fablabbcn/smartcitizen-kit-pm-board/hardware/README.md

Smart Citizen Kit 2.0 PM Board Hardware
=======================================

This folder contains the Eagle design files for the Smart Citizen Kit 2.0 PM Board

## License

All the software is released under [GNU GPL v3.0](https://github.com/fablabbcn/smartcitizen-kit-20/blob/master/LICENSE) and the hardware design files under [CERN OHL v1.2](https://github.com/fablabbcn/smartcitizen-kit-20/blob/master/hardware/LICENSE)
