fablabbcn/smartcitizen-kit-pm-board/hardware/SCK_2.0_PM_BOARD_1.1_rev_1/SCK_2.0_PM_BOARD_1.1_rev_1_BOM.ods

Part | Value | Device | Description | Provider | MPN |  | # | Val | Cas | ManRef | ProRef | Pro | Cost | Man 1 | ProRef 1 | Pro 1 | Cost 1
C1 | 22pf | CERAMIC-22PF-50V-5%-NPO(0402) | 302010018 | Seeed | CC0402JRNPO9BN220 |  | C1 | 22pF | 0402 | CC0402JRNPO9BN220 | 302010018 | SeeedStudio | 0.01 €
C10 | 100nf | CERAMIC-100NF-50V-10%-X7R(0603) | 302010138 | Seeed | CC0603KRX7R9BB104 |  | C10 | 100nF | 0603 | CC0603KRX7R9BB104 | 302010138 | SeeedStudio | 0.01 €
C11 | 100nf | CERAMIC-100NF-50V-10%-X7R(0603) | 302010138 | Seeed | CC0603KRX7R9BB104 |  | C11 | 100nF | 0603 | CC0603KRX7R9BB104 | 302010138 | SeeedStudio | 0.01 €
C12 | 100nf | CERAMIC-100NF-50V-10%-X7R(0603) | 302010138 | Seeed | CC0603KRX7R9BB104 |  | C12 | 100nF | 0603 | CC0603KRX7R9BB104 | 302010138 | SeeedStudio | 0.01 €
C13 | 100nf | CERAMIC-100NF-50V-10%-X7R(0603) | 302010138 | Seeed | CC0603KRX7R9BB104 |  | C13 | 100nF | 0603 | CC0603KRX7R9BB104 | 302010138 | SeeedStudio | 0.01 €
C14 | 100nf | CERAMIC-100NF-50V-10%-X7R(0603) | 302010138 | Seeed | CC0603KRX7R9BB104 |  | C14 | 100nF | 0603 | CC0603KRX7R9BB104 | 302010138 | SeeedStudio | 0.01 €
C15 | 2.2nf | CERAMIC-2.2NF-50V-10%-X7R(0402) | 302010022 | Seeed | CC0402KRX7R9BB222 |  | C15 | 2,2nF | 0402 | CC0402KRX7R9BB222 | 302010022 | SeeedStudio | 0.01 €
C16 | 22uF | CERAMIC-22UF-16V-10%-X7R(1206) | 302010182 | Seeed |  |  | C16 | 22uF | 1206 |  | 302010182 | SeeedStudio | 0.02 € | EMK316BB7226ML-T | 963-EMK316BB7226ML-T | Mouser | 0.87
C17 | 10uf | CERAMIC-10UF-25V-10%-X5R(1206) | 302010181 | Seeed | CC1206KKX5R8BB106 | change to 10uf OK | C17 | 22uF | 1206 |  | 302010182 | SeeedStudio | 0.02 € | EMK316BB7226ML-T | 963-EMK316BB7226ML-T | Mouser | 0.87
C18 | 100pf | CERAMIC-100PF-50V-5%-NPO(0603) | 302010076 | Seeed | CC0603JRNPO9BN101 |  | C18 | 100pF | 0603 | CC0603JRNPO98N101 | 302010076 | SeeedStudio | 0.01 €
C19 | 100nf | CERAMIC-100NF-50V-10%-X7R(0603) | 302010138 | Seeed | CC0603KRX7R9BB104 |  | C19 | 100nF | 0603 | CC0603KRX7R9BB104 | 302010138 | SeeedStudio | 0.01 €
C2 | 22pf | CERAMIC-22PF-50V-5%-NPO(0402) | 302010018 | Seeed | CC0402JRNPO9BN220 |  | C2 | 22pF | 0402 | CC0402JRNPO9BN220 | 302010018 | SeeedStudio | 0.01 €
C20 | 100nf | CERAMIC-100NF-50V-10%-X7R(0603) | 302010138 | Seeed | CC0603KRX7R9BB104 |  | C20 | 100nF | 0603 | CC0603KRX7R9BB104 | 302010138 | SeeedStudio | 0.01 €
C21 | 100nf | CERAMIC-100NF-50V-10%-X7R(0603) | 302010138 | Seeed | CC0603KRX7R9BB104 |  | C21 | 100nF | 0603 | CC0603KRX7R9BB104 | 302010138 | SeeedStudio | 0.01 €
C22 | 4.7nf | CERAMIC-4.7NF-50V-10%-X7R(0603) | 302010144 | Seeed | CC0603KRX7R9BB472 |  | C22 | 4,7nF | 0603 | CC0603KRX7R9BB472 | 302010144 | SeeedStudio | 0.01 €
C23 | 100nf | CERAMIC-100NF-50V-10%-X7R(0603) | 302010138 | Seeed | CC0603KRX7R9BB104 | add OK
C24 | 1uf | CERAMIC-1UF-25V-10%-X7R(0805) | 302010179 | Seeed | CC0805KKX7R8BB105 | add OK
C25 | 4.7uf | CERAMIC-4.7UF-25V-10%-X5R(0805) | 302010146 | Seeed | CC0805KKX5R8BB475 | add OK
C26 | 100nf | CERAMIC-100NF-50V-10%-X7R(0805) | 302010165 | Seeed | CC0805KRX7R9BB104 | add OK
C27 | 100nf | CERAMIC-100NF-50V-10%-X7R(0805) | 302010165 | Seeed | CC0805KRX7R9BB104 | add OK
C3 | 10uf | CERAMIC-10UF-25V-10%-X5R(1206) | 302010181 | Seeed | CC1206KKX5R8BB106 | change to ceramic OK | C3 | 10uF | AVX-A | TAJA106K016RNJ | 302020002 | SeeedStudio | 0.05 €
C4 | 22uF | CERAMIC-22UF-16V-10%-X7R(1206) | 302010182 | Seeed |  | change to ceramic OK | C4 | 22uF | AVX-A | TAJA226K010RNJ | 302020008 | SeeedStudio | 0.05 €
C5 | 4.7uf | CERAMIC-4.7UF-25V-10%-X5R(0805) | 302010146 | Seeed | CC0805KKX5R8BB475 |  | C5 | 4,7uF | 0805 | CC0805KKX5R8BB475 | 302010146 | SeeedStudio | 0.01 €
C6 | 100nf | CERAMIC-100NF-50V-10%-X7R(0603) | 302010138 | Seeed | CC0603KRX7R9BB104 |  | C6 | 100nF | 0603 | CC0603KRX7R9BB104 | 302010138 | SeeedStudio | 0.01 €
C7 | 1uf | CERAMIC-1UF-25V-10%-X7R(0603) | 302010139 | Seeed | CC0603KRX7R8BB105 |  | C7 | 1uF | 0603 | CC0603KRX7R8BB105 | 302010139 | SeeedStudio | 0.01 €
C8 | 100nf | CERAMIC-100NF-50V-10%-X7R(0603) | 302010138 | Seeed | CC0603KRX7R9BB104 |  | C8 | 100nF | 0603 | CC0603KRX7R9BB104 | 302010138 | SeeedStudio | 0.01 €
C9 | 100nf | CERAMIC-100NF-50V-10%-X7R(0603) | 302010138 | Seeed | CC0603KRX7R9BB104 |  | C9 | 100nF | 0603 | CC0603KRX7R9BB104 | 302010138 | SeeedStudio | 0.01 €
D1 | 20V-1A | SMD-DIODE-SCHOTTKY-20V-1A(SOD-123) | 304020034 | Seeed | B5819W |  | D1 | 20V/1A | SOD-123 | B5819W | 304020034 | SeeedStudio | 0.02 €
D2 | 20V-1A | SMD-DIODE-SCHOTTKY-20V-1A(SOD-123) | 304020034 | Seeed | B5819W |  | D2 | 20V/1A | SOD-123 | B5819W | 304020034 | SeeedStudio | 0.02 €
D3 | 20V-500MA | SMD-DIODE-SCHOTTKY-20V-500MA(SOD-123)P | 304020028 | Seeed | MBR0520LT1G |  | D3 | 20V/500mA | SOD-123 | MBR0520LT1G | 304020028 | SeeedStudio | 0.03 €
D4 | 20V-500MA | SMD-DIODE-SCHOTTKY-20V-500MA(SOD-123)P | 304020028 | Seeed | MBR0520LT1G |  | D4 | 20V/500mA | SOD-123 | MBR0520LT1G | 304020028 | SeeedStudio | 0.03 €
D5 | 20V-500MA | SMD-DIODE-SCHOTTKY-20V-500MA(SOD-123)P | 304020028 | Seeed | MBR0520LT1G |  | D5 | 20V/500mA | SOD-123 | MBR0520LT1G | 304020028 | SeeedStudio | 0.03 €
D6 | 20V-500MA | SMD-DIODE-SCHOTTKY-20V-500MA(SOD-123)P | 304020028 | Seeed | MBR0520LT1G |  | D6 | 20V/500mA | SOD-123 | MBR0520LT1G | 304020028 | SeeedStudio | 0.03 €
D7 | 20V-500MA | SMD-DIODE-SCHOTTKY-20V-500MA(SOD-123)P | 304020028 | Seeed | MBR0520LT1G |  | D7 | 20V/500mA | SOD-123 | MBR0520LT1G | 304020028 | SeeedStudio | 0.03 €
IC1 | SAMD21G18A-MUT | Atmel D21 32bit ARM Cortex-M0 microcontroller - 48 PIN TQFP | 310010095 | Seeed | SAMD21G18A-MUT |  | IC1 | SAM | VFQFN-48 | ATSAMD21G18A-MU | 310010095 | SeeedStudio | 3.14 €
J1 | MYCON2_USB-MINI-B | HANGAR_MYCON2_USB-MINI-B | 320010003 | Seeed | 10118193-0001LF |  | J1 | USB | 5P-90D | 10118193-0001LF | 320010003 | SeeedStudio | 0.38 €
J10 | GROVE-CONNECTOR | CONNECTOR-NEW_GROVE-CONNECTOR-SMD90D | 320110032 | Seeed | 1125R-SMT-4P |  | J10 | GrooveADCB | 4P-SMD-2.0-90D | 1125R-SMT-4P | 320110032 | SeeedStudio | 0.04 €
J2 | GROVE-CONNECTOR | CONNECTOR-NEW_GROVE-CONNECTOR-SMD90D | 320110032 | Seeed | 1125R-SMT-4P |  | J2 | GrooveA | 4P-SMD-2.0-90D | 1125R-SMT-4P | 320110032 | SeeedStudio | 0.04 €
J3 | GROVE-CONNECTOR | CONNECTOR-NEW_GROVE-CONNECTOR-SMD90D | 320110032 | Seeed | 1125R-SMT-4P |  | J3 | GrooveB | 4P-SMD-2.0-90D | 1125R-SMT-4P | 320110032 | SeeedStudio | 0.04 €
J4 | PINHD-2X5SMD | HANGAR_PINHEAD_PINHD-2X5SMD | 609-3695-1-ND | DigiKey | 20021121-00010C4LF |  | J4 | Amphenol FCL | 1,27x2x5 | 20021121-00010C4LF | 609-3695-1-ND | Digikey | 0.67 €
J5 | MOLEX_PICOBLADE_8PIN | MOLEX_53398-0871_8PIN | WM7612DKR-ND | DigiKey | 53398-0871 |  | J5 | 8 x 1 | 1.25MM VERT | 53398-0871 | WM7612DKR-ND | Digikey | 1.31 €
J6 | MOLEX_PICOBLADE_8PIN | MOLEX_53398-0871_8PIN | WM7612DKR-ND | DigiKey | 53398-0871 |  | J6 | 8 x 1 | 1.25MM VERT | 53398-0871 | WM7612DKR-ND | Digikey | 1.31 €
J7 | GROVE-CONNECTOR | CONNECTOR-NEW_GROVE-CONNECTOR-SMD90D | 320110032 | Seeed | 1125R-SMT-4P |  | J7 | GrooveGPIO | 4P-SMD-2.0-90D | 1125R-SMT-4P | 320110032 | SeeedStudio | 0.04 €
J8 | GROVE-CONNECTOR | CONNECTOR-NEW_GROVE-CONNECTOR-SMD90D | 320110032 | Seeed | 1125R-SMT-4P |  | J8 | GrooveADCA | 4P-SMD-2.0-90D | 1125R-SMT-4P | 320110032 | SeeedStudio | 0.04 €
J9 | GROVE-CONNECTOR | CONNECTOR-NEW_GROVE-CONNECTOR-SMD90D | 320110032 | Seeed | 1125R-SMT-4P |  | J9 | GrooveUART | 4P-SMD-2.0-90D | 1125R-SMT-4P | 320110032 | SeeedStudio | 0.04 €
L1 | 2.2uH | L5040S | 303010103 | Seeed | SWPA5020S2R2NT | NOT CHANGE | L1 | 2,2uH | L5040S | SWPA5020S2R2NT | 303010103 | SeeedStudio | 0.05 €
LED1 | LED_RGB_CAASMB-MTB0-0A3A2 | HANGAR_LED_RGB_CAASMB-MTB0-0A3A2 | 516-3279-1-ND | Digikey | CA ASMB-MTB0-0A3A2 |  | LED1 | RGB | SMB | CA ASMB-MTB0-0A3A2 | 516-3279-1-ND | Digikey | 0.46 €
Q1 | BSS138W-7-F | SMD-MOSFET-N-CH-50V-200MA-BSS138W-7-F(SOT-23) | 305030000 | Seeed | BSS138W-7-F |  | Q1 | NMOS50V200mA | SOT323-3 | BSS138W-7-F | 305030000 | SeeedStudio | 0.03 €
Q2 | PMOS DUAL | MOSFETP_BOTH | SIA923AEDJ-T1-GE3CT-ND | Digikey | SIA923AEDJ-T1-GE3CT-ND |  | Q2 | PMOS DUAL | PowerPAK SC-70-6 Dual | SIA923AEDJ-T1-GE3 | SIA923AEDJ-T1-GE3CT-ND | Digikey | 0.64 €
Q3 | BSS138W-7-F | SMD-MOSFET-N-CH-50V-200MA-BSS138W-7-F(SOT-23) | 305030000 | Seeed | BSS138W-7-F | add OK
Q4 | BSS138W-7-F | SMD-MOSFET-N-CH-50V-200MA-BSS138W-7-F(SOT-23) | 305030000 | Seeed | BSS138W-7-F | add OK
R1 | 10K 1/10W | SMD-RES-10K-5%-1/10W(0603) | 301010293 | Seeed | RC0603JR-0710KL |  | R1 | 10k | 0603 | RC0603JR-0710KL | 301010293 | SeeedStudio | 0.01 €
R10 | 10K 1/16W | SMD-RES-10K-1%-1/16W(0402) | 301010047 | Seeed | RC0402FR-0710KL | change to 0402 OK | R10 | 10k | 0603 | RC0603JR-0710KL | 301010293 | SeeedStudio | 0.01 €
R11 | 10K 1/16W | SMD-RES-10K-1%-1/16W(0402) | 301010047 | Seeed | RC0402FR-0710KL | change to 0402 OK | R11 | 10k | 0603 | RC0603JR-0710KL | 301010293 | SeeedStudio | 0.01 €
R12 | 330R | SMD-RES-330R-1%-1/10W(0603) | 301010300 | Seeed | RC0603FR-07330RL |  | R12 | 330R | 0603 | RC0603FR-07330RL | 301010300 | SeeedStudio | 0.01 €
R13 | 1M | SMD-RES-1M-1%-1/10W(0603) | 301010151 | Seeed | RC0603FR-071ML |  | R13 | 1M | 0603 | RC0603FR-071ML | 301010151 | SeeedStudio | 0.01 €
R14 | 100K 1/16W | SMD-RES-100K-5%-1/16W(0402) | 301010033 | Seeed | RC0402JR-07100KL | add OK
R15 | 100K 1/16W | SMD-RES-100K-5%-1/16W(0402) | 301010033 | Seeed | RC0402JR-07100KL | add OK
R2 | 10K 1/10W | SMD-RES-10K-5%-1/10W(0603) | 301010293 | Seeed | RC0603JR-0710KL |  | R2 | 10k | 0603 | RC0603JR-0710KL | 301010293 | SeeedStudio | 0.01 €
R3 | 1K | SMD-RES-1K-5%-1/16W(0402) | 301010006 | Seeed | RC0402JR-071KL | change to 0402 OK | R3 | 1k | 0603 | RC0603JR-071KL | 301010291 | SeeedStudio | 0.01 €
R4 | 1K | SMD-RES-1K-5%-1/16W(0402) | 301010006 | Seeed | RC0402JR-071KL | change to 0402 OK | R4 | 1k | 0603 | RC0603JR-071KL | 301010291 | SeeedStudio | 0.01 €
R5 | 1K | SMD-RES-1K-5%-1/16W(0402) | 301010006 | Seeed | RC0402JR-071KL | change to 0402 OK | R5 | 1k | 0603 | RC0603JR-071KL | 301010291 | SeeedStudio | 0.01 €
R6 | 10K | SMD-RES-10K-1%-1/10W(0603) | 301010299 | Seeed | RC0603FR-0710KL |  | R6 | 10k | 0603 | RC0603FR-0710KL | 301010299 | SeeedStudio | 0.01 €
R7 | 10K 1/16W | SMD-RES-10K-1%-1/16W(0402) | 301010047 | Seeed | RC0402FR-0710KL | change to 0402 OK | R7 | 10k | 0603 | RC0603FR-0710KL | 301010299 | SeeedStudio | 0.01 €
 |  |  |  | Seeed | RC0603JR-0722KL | cancel R8 OK | R8 | 100k | 0402 | RC0402JR-07100KL | 301010033 | SeeedStudio | 0.01 €
R9 | 22K | SMD-RES-22K-5%-1/10W(0603) | 301010132 | DigiKey | TPD4S012DRYR |  | R9 | 22k | 0603 | RC0603FR-0722KL | 301010132 | SeeedStudio | 0.01 €
TVS1 | -0,3-20V | SON_6 | 304050020 | Seeed | D4S012DRYR | NOT CHANGE | TVS1 | -0,3-20V | SON-6 | D4S012DRYR | 304050020 | SeeedStudio | 0.25 €
U1 | 3V3 | SOT89-3L | 310030095 | Seeed | CJA1117B-3.3 |  | U1 | 3V3 | SOT89-3L | CJA1117B-3.3 | 310030095 | SeeedStudio | 0.07 €
U2 | 5V | SOT23-5 | 310030153 | Seeed | ETA1036-50S2F-T |  | U2 | 5V | SOT23-5 | ETA1036-50S2F-T | 310030153 | SeeedStudio | 0.17 €
Y1 | 32,768Khz | 0213_ABS07-32.768KHZ-T | 535-9542-1-ND | DigiKey | ABS07-32.768KHZ-T |  | Y1 | 32,768k | 0213 | ABS07-32.768KHZ-T | 535-9542-1-ND | Digikey | 0.91 €
