fablabbcn/smartcitizen-kit-pm-board/hardware/SCK_2.0_PM_BOARD_1.1_rev_1/SCK_2.0_PM_BOARD_1.1_rev_1.pdf

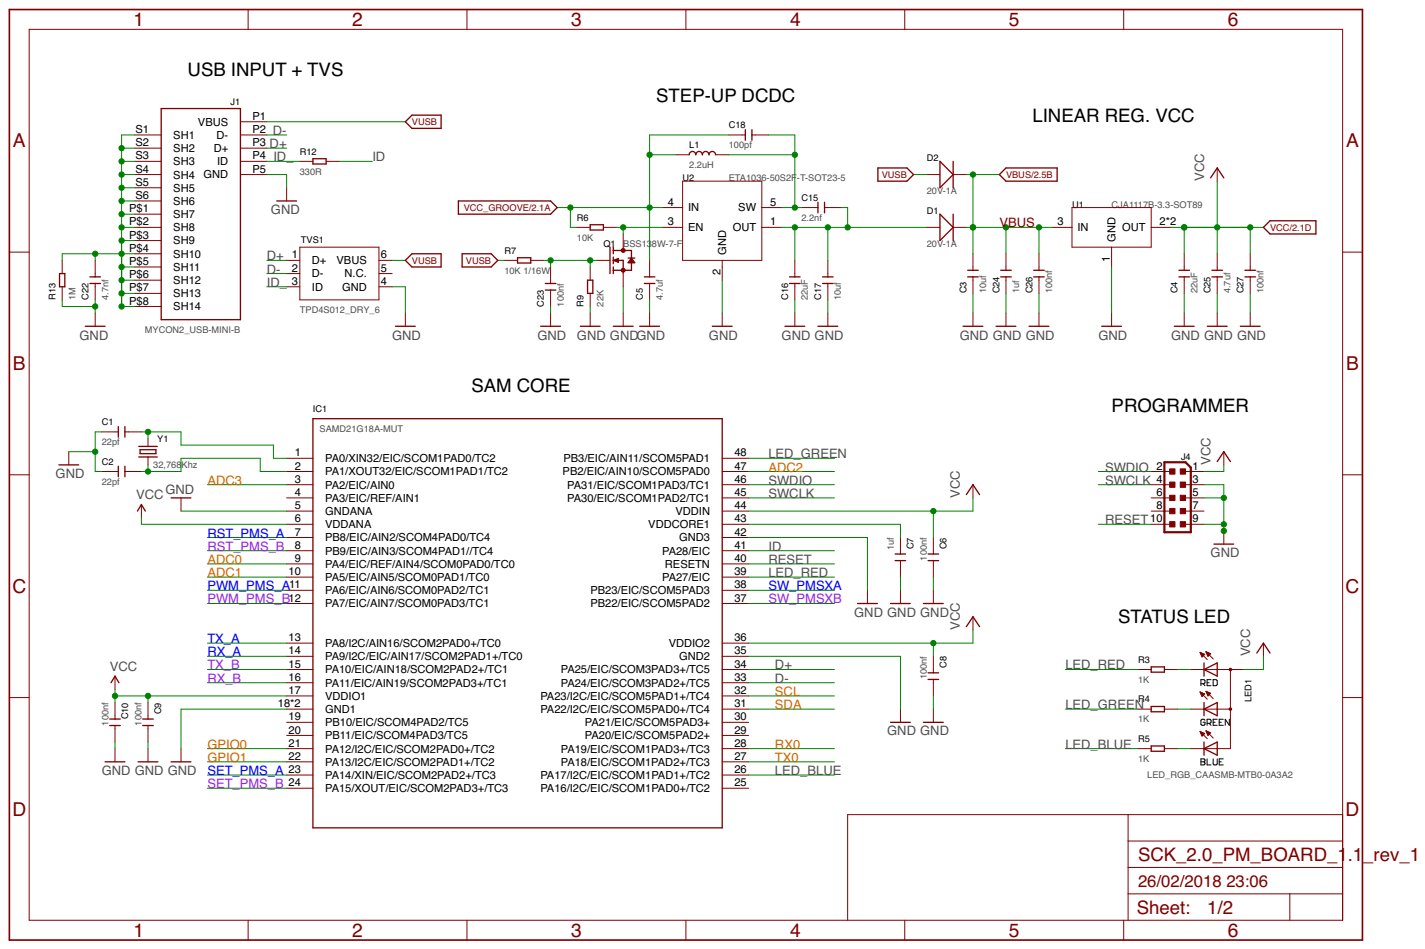
[picture p5: page 1]

10uf GND GND GND GND
