fablabbcn/smartcitizen-kit-pm-board/hardware/SCK_2.0_PM_BOARD_1.1_rev_1/SCK_2.0_PM_BOARD_1.1_rev_1.sch

## EAGLE design hardware/SCK_2.0_PM_BOARD_1.1_rev_1/SCK_2.0_PM_BOARD_1.1_rev_1.sch (2018-03-20)

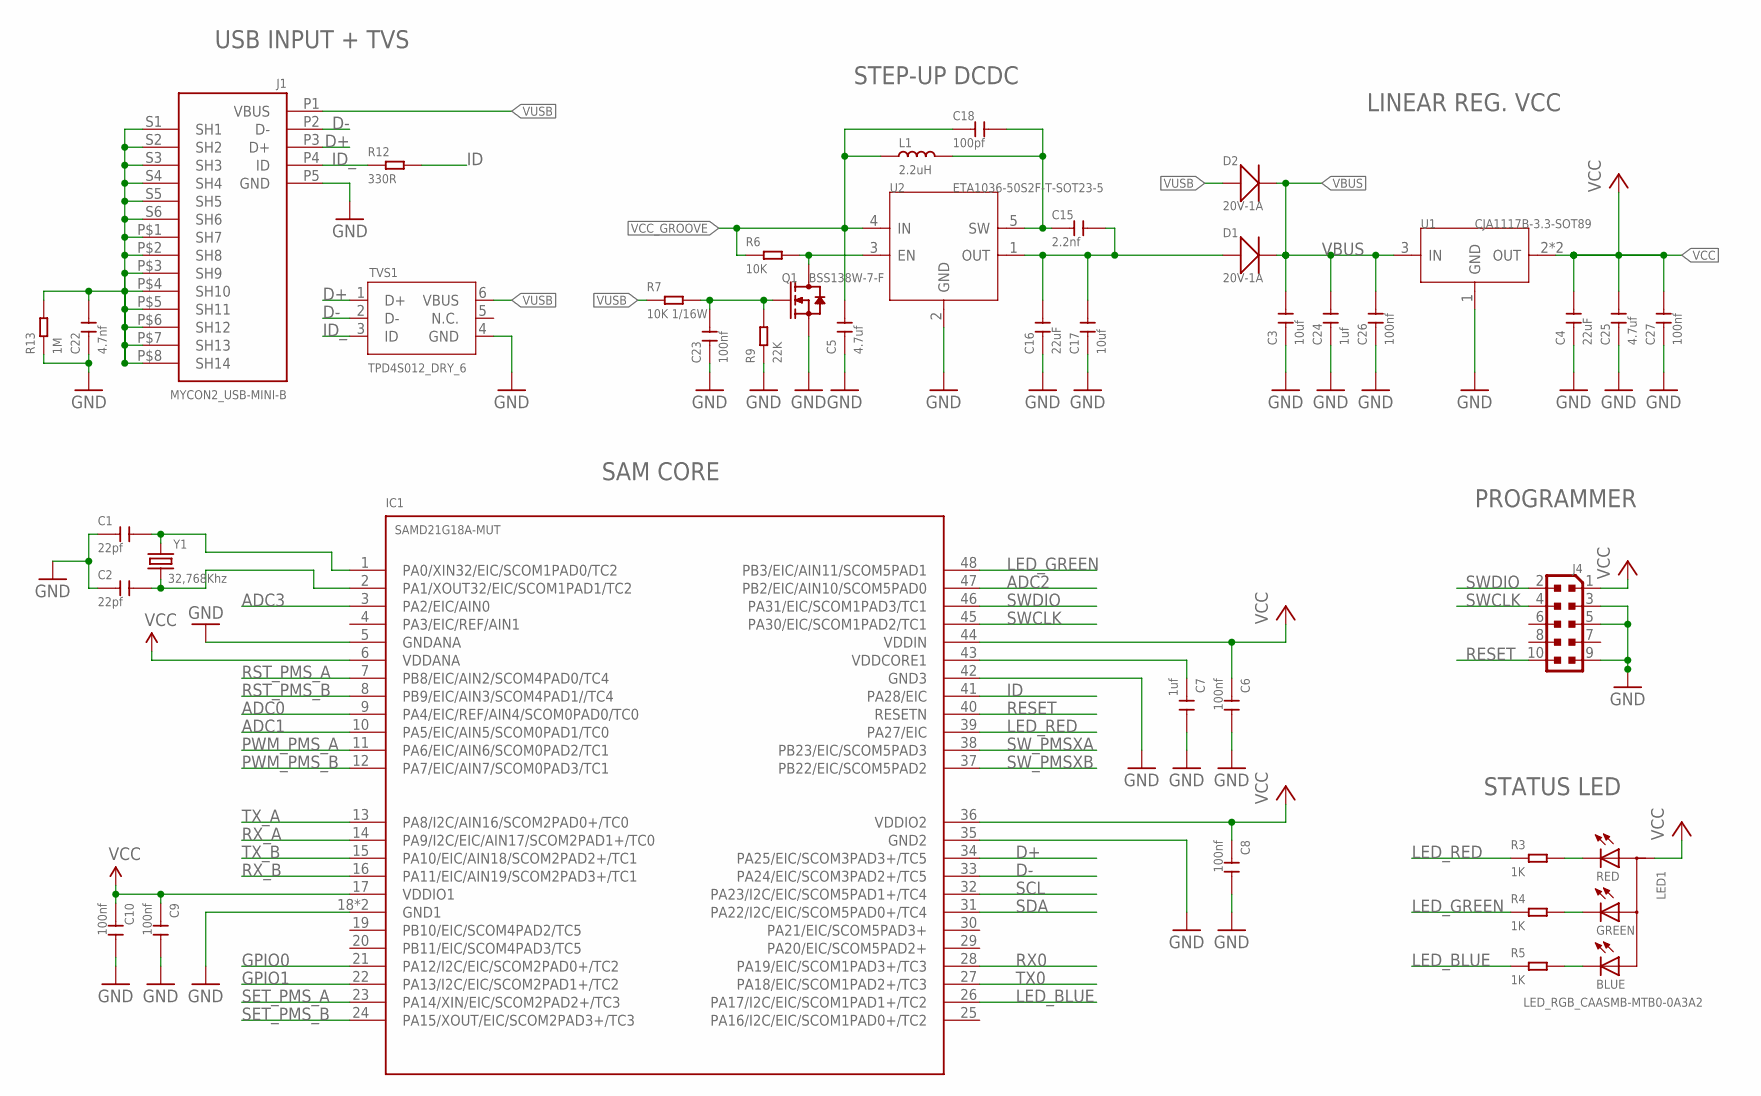
[picture p6: schematic SCK_2.0_PM_BOARD_1.1_rev_1.sch, sheet 1]

Parts:
C1, C2: 22pf; C0402
C3, C17: 10uf; C1206
C4, C16: 22uF; C1206
C5, C25: 4.7uf; C0805
C6, C8, C9, C10, C23: 100nf; C0603
C7: 1uf; C0603
C15: 2.2nf; C0402
C18: 100pf; C0603
C22: 4.7nf; C0603
C24: 1uf; C0805
C26, C27: 100nf; C0805
D1, D2: 20V-1A; SOD-123
IC1: SAMD21G18A-MUT; HANGAR_QFN48-7X7
J1: MYCON2_USB-MINI-B; HANGAR_CON2_USB_MICRO_B_AT
J4: HANGAR_PINHEAD_PINHD-2X5SMD; HANGAR_2X05_SMD_1.27MM
L1: 2.2uH; L5040S
LED1: LED_RGB_CAASMB-MTB0-0A3A2; HANGAR_P-LCC-4
Q1: BSS138W-7-F; SOT-23
R3, R4, R5: 1K; R0402
R6: 10K; R0603
R7: 10K 1/16W; R0402
R9: 22K; R0603
R12: 330R; R0603
R13: 1M; R0603
TVS1: TPD4S012_DRY_6; DRY6
U1: CJA1117B-3.3-SOT89; SOT-89
U2: ETA1036-50S2F-T-SOT23-5; SOT-23-5
Y1: 32,768Khz; RESONATOR_EPSON_FC_145

Connections:
ADC0: IC1.9 (PA4/EIC/REF/AIN4/SCOM0PAD0/TC0)
ADC1: IC1.10 (PA5/EIC/AIN5/SCOM0PAD1/TC0)
ADC2: IC1.47 (PB2/EIC/AIN10/SCOM5PAD0)
ADC3: IC1.3 (PA2/EIC/AIN0)
D+: IC1.34 (PA25/EIC/SCOM3PAD3+/TC5), J1.P3 (D+), TVS1.1 (D+)
D-: IC1.33 (PA24/EIC/SCOM3PAD2+/TC5), J1.P2 (D-), TVS1.2 (D-)
GND: C1.1, C2.1, C3.1, C4.1, C5.1, C6.2, C7.2, C8.2, C9.2, C10.2, C16.1, C17.1, C22.1, C23.1, C24.1, C25.1, C26.1, C27.1, IC1.5 (GNDANA), IC1.18 (GND1), IC1.35 (GND2), IC1.42 (GND3), J1.P5 (GND), J4.3, J4.5, J4.9, Q1.2 (S), R9.1, R13.1, TVS1.4 (GND), U1.1 (GND), U2.2 (GND)
GPIO0: IC1.21 (PA12/I2C/EIC/SCOM2PAD0+/TC2)
GPIO1: IC1.22 (PA13/I2C/EIC/SCOM2PAD1+/TC2)
ID: IC1.41 (PA28/EIC), R12.2
ID_: J1.P4 (ID), R12.1, TVS1.3 (ID)
LED_BLUE: IC1.26 (PA17/I2C/EIC/SCOM1PAD1+/TC2), R5.1
LED_GREEN: IC1.48 (PB3/EIC/AIN11/SCOM5PAD1), R4.1
LED_RED: IC1.39 (PA27/EIC), R3.1
unnamed: LED1.4 (RED), R3.2
unnamed: LED1.3 (GREEN), R4.2
unnamed: LED1.2 (BLUE), R5.2
unnamed: C7.1, IC1.43 (VDDCORE1)
unnamed: Q1.3 (D), R6.2, U2.3 (EN)
unnamed: C23.2, Q1.1 (G), R7.2, R9.2
unnamed: C15.1, C18.2, L1.2, U2.5 (SW)
PA00_XIN32: C1.2, IC1.1 (PA0/XIN32/EIC/SCOM1PAD0/TC2), Y1.P$2 (2)
PA01_XOUT32: C2.2, IC1.2 (PA1/XOUT32/EIC/SCOM1PAD1/TC2), Y1.P$1 (1)
PWM_PMS_A: IC1.11 (PA6/EIC/AIN6/SCOM0PAD2/TC1)
PWM_PMS_B: IC1.12 (PA7/EIC/AIN7/SCOM0PAD3/TC1)
RESET: IC1.40 (RESETN), J4.10
RST_PMS_A: IC1.7 (PB8/EIC/AIN2/SCOM4PAD0/TC4)
RST_PMS_B: IC1.8 (PB9/EIC/AIN3/SCOM4PAD1//TC4)
RX0: IC1.28 (PA19/EIC/SCOM1PAD3+/TC3)
RX_A: IC1.14 (PA9/I2C/EIC/AIN17/SCOM2PAD1+/TC0)
RX_B: IC1.16 (PA11/EIC/AIN19/SCOM2PAD3+/TC1)
SCL: IC1.32 (PA23/I2C/EIC/SCOM5PAD1+/TC4)
SDA: IC1.31 (PA22/I2C/EIC/SCOM5PAD0+/TC4)
SET_PMS_A: IC1.23 (PA14/XIN/EIC/SCOM2PAD2+/TC3)
SET_PMS_B: IC1.24 (PA15/XOUT/EIC/SCOM2PAD3+/TC3)
SHIELD: C22.2, J1.P$1 (SH7), J1.P$2 (SH8), J1.P$3 (SH9), J1.P$4 (SH10), J1.P$5 (SH11), J1.P$6 (SH12), J1.P$7 (SH13), J1.P$8 (SH14), J1.S1 (SH1), J1.S2 (SH2), J1.S3 (SH3), J1.S4 (SH4), J1.S5 (SH5), J1.S6 (SH6), R13.2
SWCLK: IC1.45 (PA30/EIC/SCOM1PAD2/TC1), J4.4
SWDIO: IC1.46 (PA31/EIC/SCOM1PAD3/TC1), J4.2
SW_PMSXA: IC1.38 (PB23/EIC/SCOM5PAD3)
SW_PMSXB: IC1.37 (PB22/EIC/SCOM5PAD2)
TX0: IC1.27 (PA18/EIC/SCOM1PAD2+/TC3)
TX_A: IC1.13 (PA8/I2C/AIN16/SCOM2PAD0+/TC0)
TX_B: IC1.15 (PA10/EIC/AIN18/SCOM2PAD2+/TC1)
VBUS: C3.2, C24.2, C26.2, D1.-, D2.-, U1.3 (IN)
VCC: C4.2, C6.1, C8.1, C9.1, C10.1, C25.2, C27.2, IC1.6 (VDDANA), IC1.17 (VDDIO1), IC1.36 (VDDIO2), IC1.44 (VDDIN), J4.1, LED1.1 (A), U1.2 (OUT)
VCC_GROOVE: C5.2, C18.1, L1.1, R6.1, U2.4 (IN)
VO_DCDC: C15.2, C16.2, C17.2, D1.+, U2.1 (OUT)
VUSB: D2.+, J1.P1 (VBUS), R7.1, TVS1.6 (VBUS)

Notes on the sheet:
USB INPUT + TVS
STEP-UP DCDC
LINEAR REG. VCC
STATUS LED
PROGRAMMER
SAM CORE

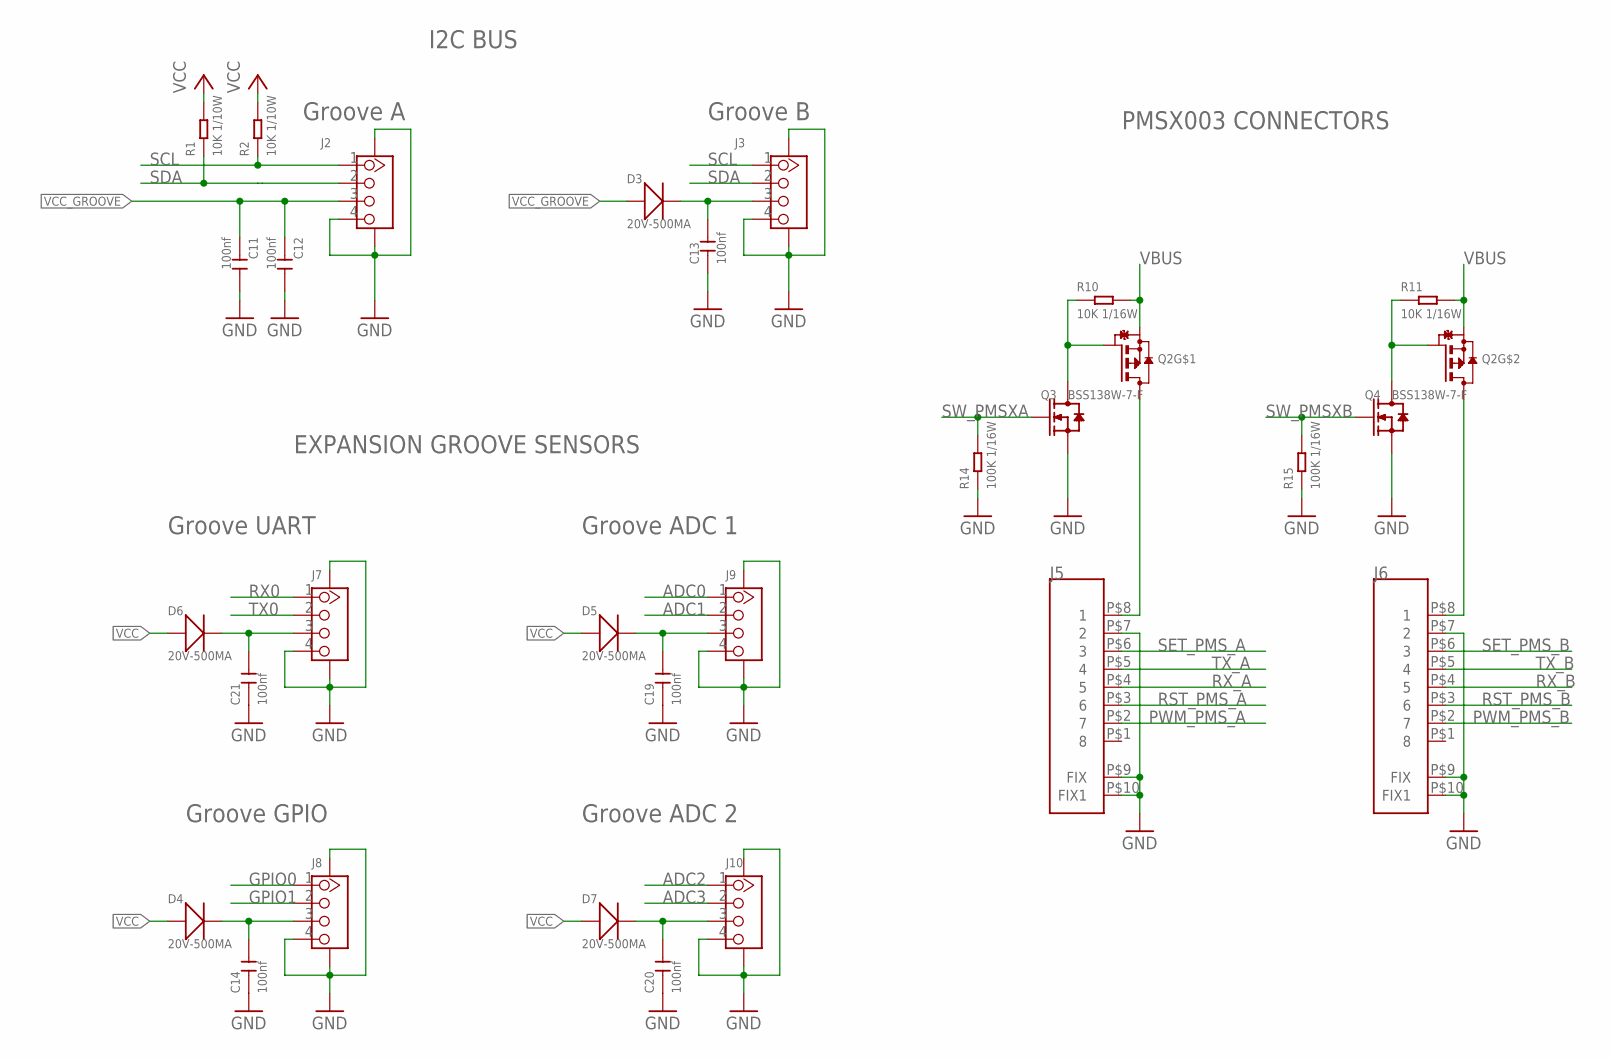
[picture p7: schematic SCK_2.0_PM_BOARD_1.1_rev_1.sch, sheet 2]

Parts:
C11, C12, C13, C14, C19, C20, C21: 100nf; C0603
D3, D4, D5, D6, D7: 20V-500MA; SOD-123
J2, J3, J7, J8, J9, J10: CONNECTOR-NEW_GROVE-CONNECTOR-SMD90D; CONNECTOR-NEW_HW4-SMD-2.0-90D
J5, J6: MOLEX_53398-0871_8PIN; MOLEX_PICOBLADE_8PIN
Q2: MOSFETP_BOTH; HANGAR_POWERPAKSC70-6L
Q3, Q4: BSS138W-7-F; SOT-23
R1, R2: 10K 1/10W; R0603
R10, R11: 10K 1/16W; R0402
R14, R15: 100K 1/16W; R0402

Connections:
ADC0: J9.1
ADC1: J9.2
ADC2: J10.1
ADC3: J10.2
GND: C11.2, C12.2, C13.2, C14.1, C19.1, C20.1, C21.1, J2.4, J2.SS1, J2.SS2, J3.4, J3.SS1, J3.SS2, J5.P$7 (2), J5.P$9 (FIX), J5.P$10 (FIX1), J6.P$7 (2), J6.P$9 (FIX), J6.P$10 (FIX1), J7.4, J7.SS1, J7.SS2, J8.4, J8.SS1, J8.SS2, J9.4, J9.SS1, J9.SS2, J10.4, J10.SS1, J10.SS2, Q3.2 (S), Q4.2 (S), R14.1, R15.1
GPIO0: J8.1
GPIO1: J8.2
unnamed: J5.P$8 (1), Q2.6 (D)
unnamed: J6.P$8 (1), Q2.3 (D)
unnamed: C14.2, D4.-, J8.3
unnamed: C19.2, D5.-, J9.3
unnamed: C21.2, D6.-, J7.3
unnamed: C20.2, D7.-, J10.3
unnamed: C13.1, D3.-, J3.3
PWM_PMS_A: J5.P$2 (7)
PWM_PMS_B: J6.P$2 (7)
RST_PMS_A: J5.P$3 (6)
RST_PMS_B: J6.P$3 (6)
RX0: J7.1
RX_A: J5.P$4 (5)
RX_B: J6.P$4 (5)
SCL: J2.1, J3.1, R2.1
SDA: J2.2, J3.2, R1.1
SET_PMS_A: J5.P$6 (3)
SET_PMS_B: J6.P$6 (3)
SW_PMSXA: Q3.1 (G), R14.2
SW_PMSXA_NEG: Q2.2 (G), Q3.3 (D), R10.1
SW_PMSXB: Q4.1 (G), R15.2
SW_PMSXB_NEG: Q2.5 (G), Q4.3 (D), R11.1
TX0: J7.2
TX_A: J5.P$5 (4)
TX_B: J6.P$5 (4)
VBUS: Q2.1 (S), Q2.4 (S), R10.2, R11.2
VCC: D4.+, D5.+, D6.+, D7.+, R1.2, R2.2
VCC_GROOVE: C11.1, C12.1, D3.+, J2.3

Notes on the sheet:
Groove GPIO
Groove ADC 1
Groove UART
Groove ADC 2
PMSX003 CONNECTORS
Groove A
Groove B
I2C BUS
EXPANSION GROOVE SENSORS
