fablabbcn/smartcitizen-kit-pm-board/(commit log)

2018-03-20 Added schematic
    [SCK_PMSDRV_1.1_rev_1_advert_0.sch]
2018-04-26 Fix on turning on PMS Change led color on first PMS detected
    [PM_tested.ino, pins.cpp]
2018-05-19 If two sensors are found return average of both
2018-05-19 Fix when no PM device available
    [PM_driver.ino]
2018-07-27 Avoid starting multiple times
    [PM_driver.cpp, PM_driver.h]
2018-07-30 Fix PM sensor not starting after manual stop
    [PM_driver.ino]
2018-08-23 Added support to oneWire DS18B20 temperature sensor on GPIO connector.
2018-09-03 Fix detection problems on Dallas temperature sensor
    [PM_driver.cpp]
2018-09-03 Improved PM sensor detection
2019-01-22 Implemented PM sensor extra metrics
2019-01-28 Removed repeated PM UAE sensors
2019-03-01 Fix on random reading error
    [PM_driver.cpp, PM_driver.h, PM_driver.ino]
2019-03-05 Added checksum and more robust parsing Fix wrong values on some situations
    [PM_driver.cpp, PM_driver.h, PM_driver.ino]
2020-07-10 GPS I2C working
2020-07-14 Avoid fake PM sensor detection
    [PM_driver.ino]
2020-07-14 Fix memory address for GPS data
    [PM_driver.cpp]
2020-12-02 Manage PM A/B as separate instances. Removed PM average sensor. Fix PM startup problems.
    [PM_driver.cpp, PM_driver.h, PM_driver.ino]
2020-12-02 Fix error on calculating time since last good reading. Debug messages updates.
    [PM_driver.cpp, PM_driver.ino, pins.h]
